Kamalesh2026/DIY-Hydrogel-Touch-Sensor/README.md

# DIY-Hydrogel-Touch-Sensor
Hydrogel Pyramidal Needle based Touch sensor using touch stress as mechanical input and resistance change as output.
