Kamalesh2026/DIY-Hydrogel-Touch-Sensor/Documentation.pptx

## Mechanical Stimuli Based Touch and Tap Sensor to render resistive Output

Kamalesh Roy
kroy.nano21@gmail.com
roykamalesh.acdm@gmail.com

## Slide 2

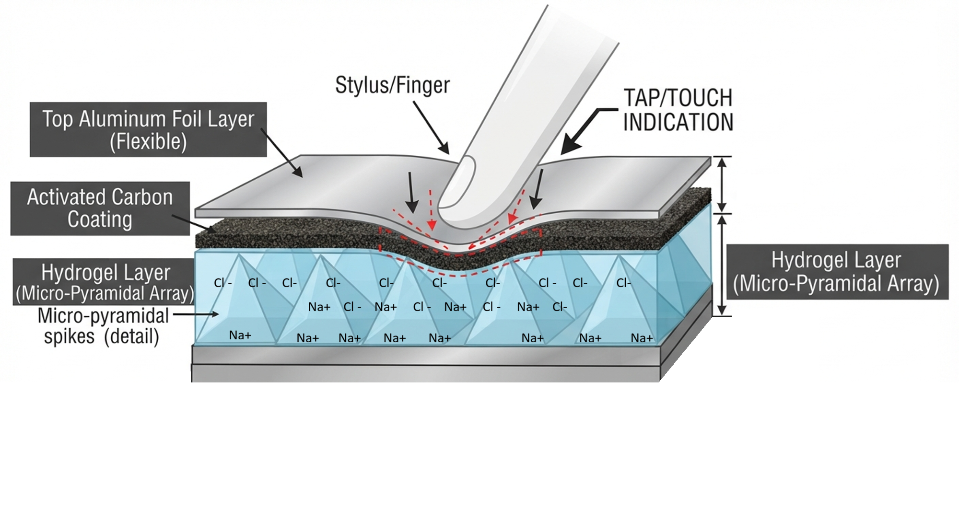
[picture p1: figure]

Pyramidal PVA Hydrogel Structures Soaked in NaCl Electrolyte

Converts touch into Resistance change

## Slide 3

3D Printed PLA Template

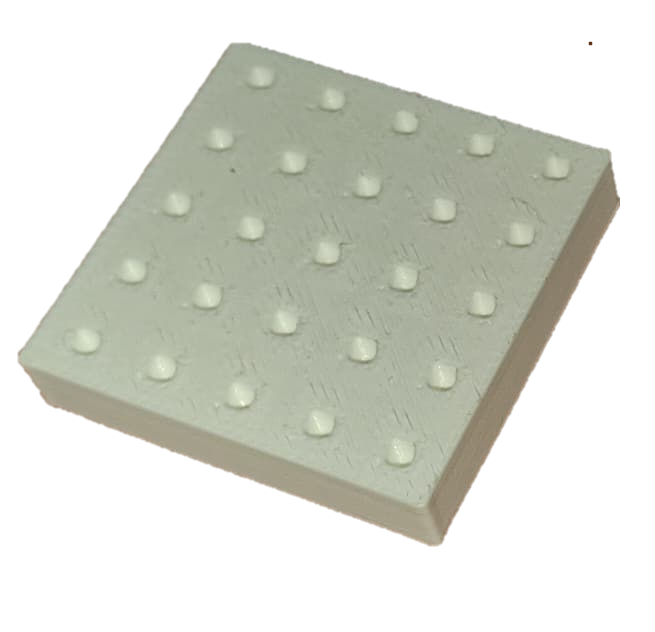
[picture p2: figure]
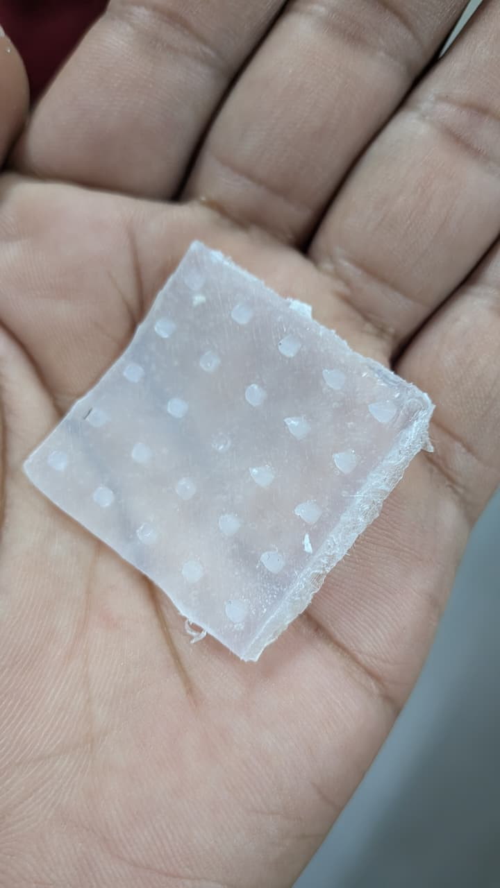
[picture p3: figure]
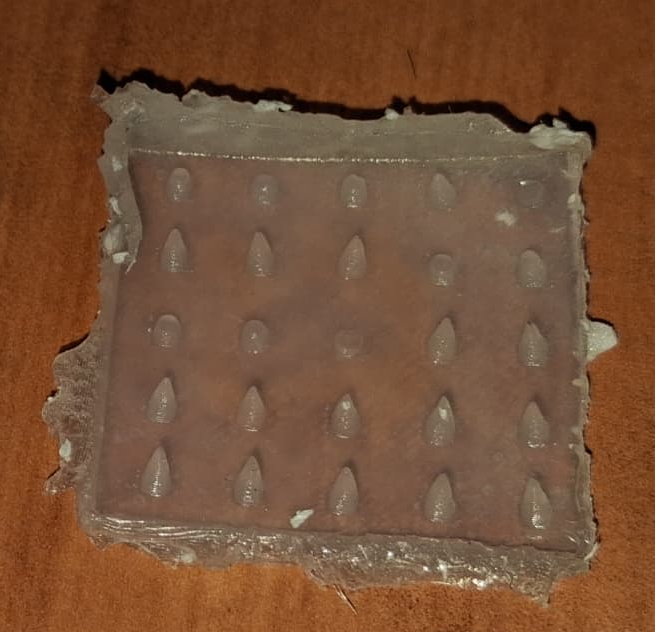
[picture p4: figure]

PVA Hydrogel
Casting, 13% PVA

3 Cycles of Freezing & Thawing,
(20 hr at -20 degree C) and 4 hr at Room temperature.

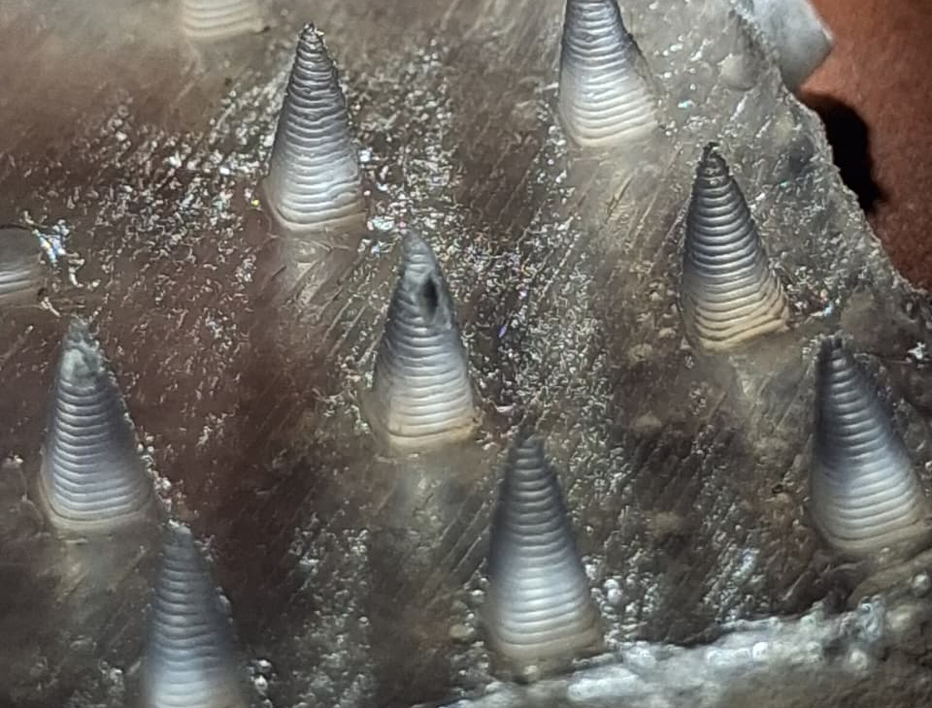
[picture p5: figure]
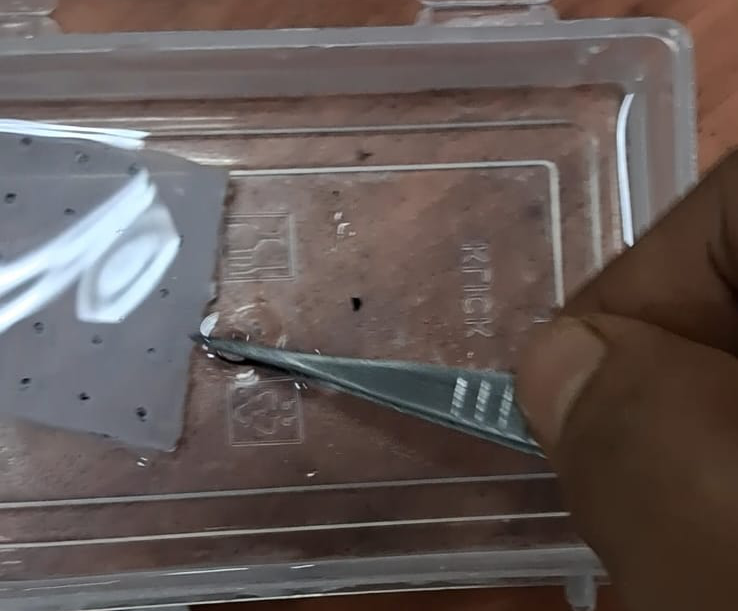
[picture p6: figure]

Making The gel conductive with Electrolyte immersion

## Slide 4

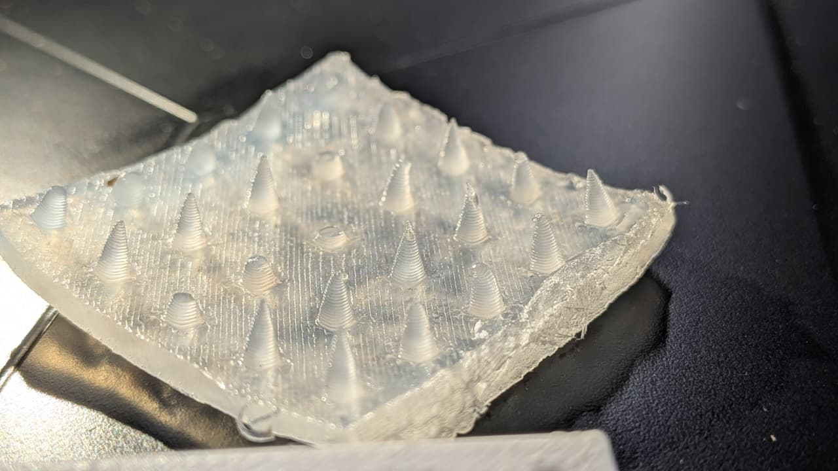
[picture p7: figure]

Hydrogel Layer with Pyramidal Needles after 3 cycles of Freezing & Thawing

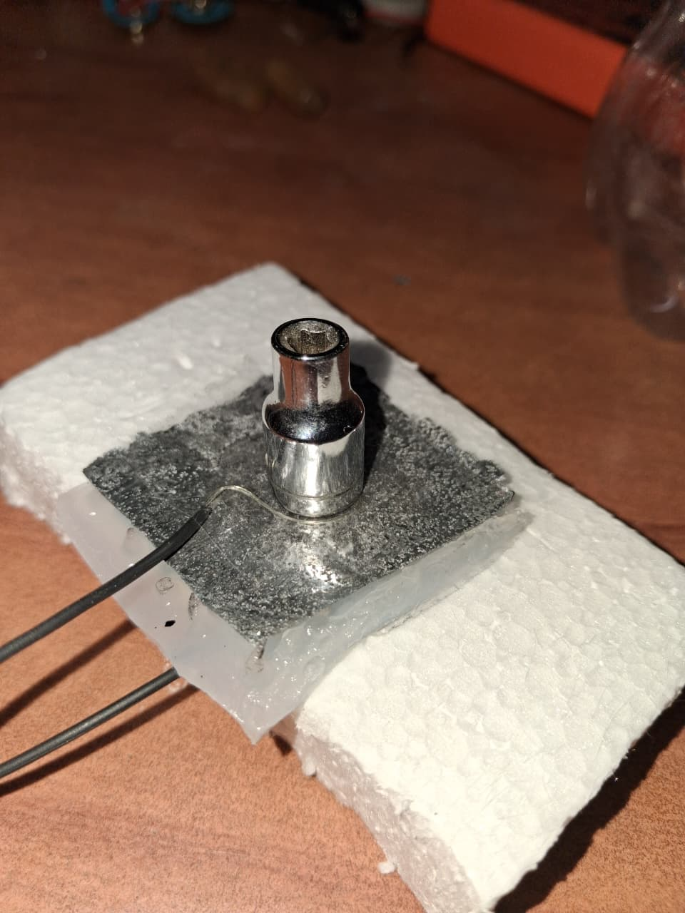
[picture p8: figure]

Hydrogel Layer between two electrode with weight.

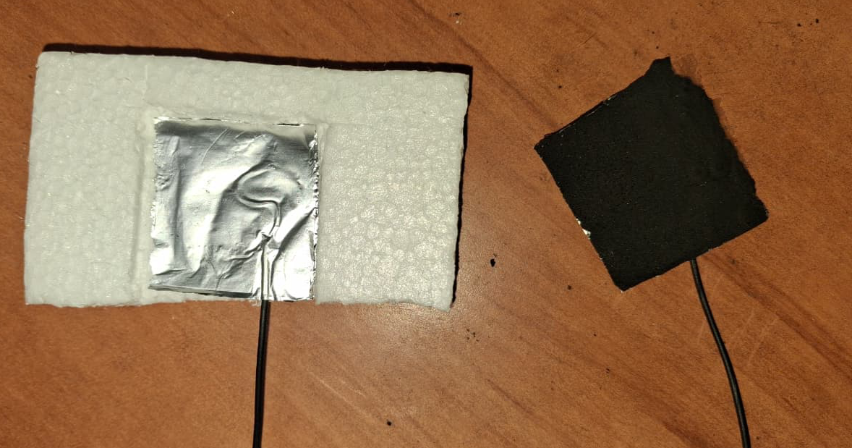
[picture p9: figure]

Bottom Electrode, Al Sheet

Top Electrode, Al Sheet Coated with Activated Carbon Paint

## Slide 5

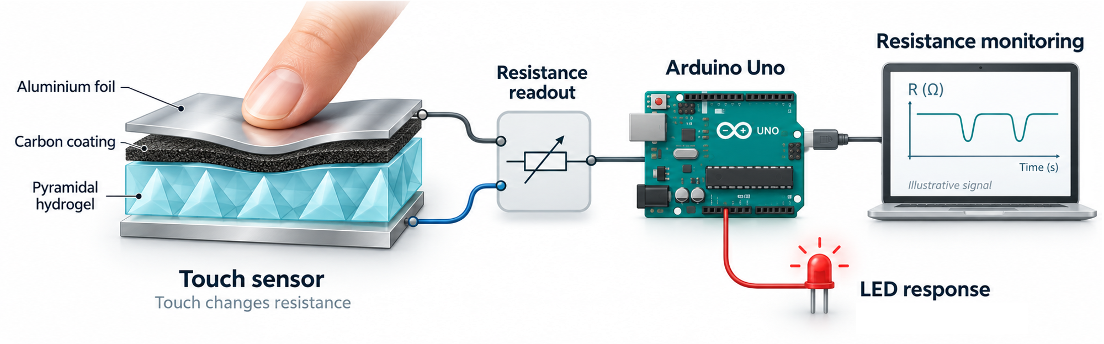
[picture p10: figure]
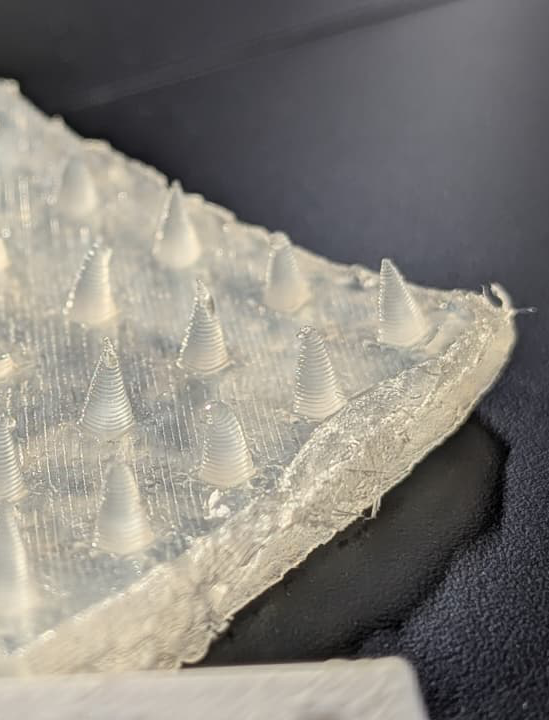
[picture p11: figure]
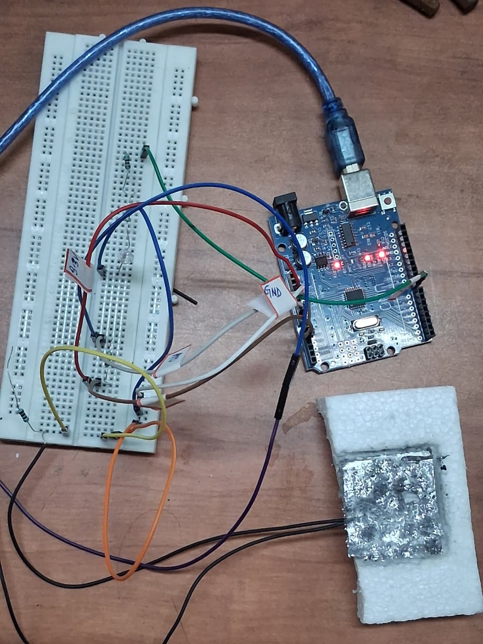
[picture p12: figure]
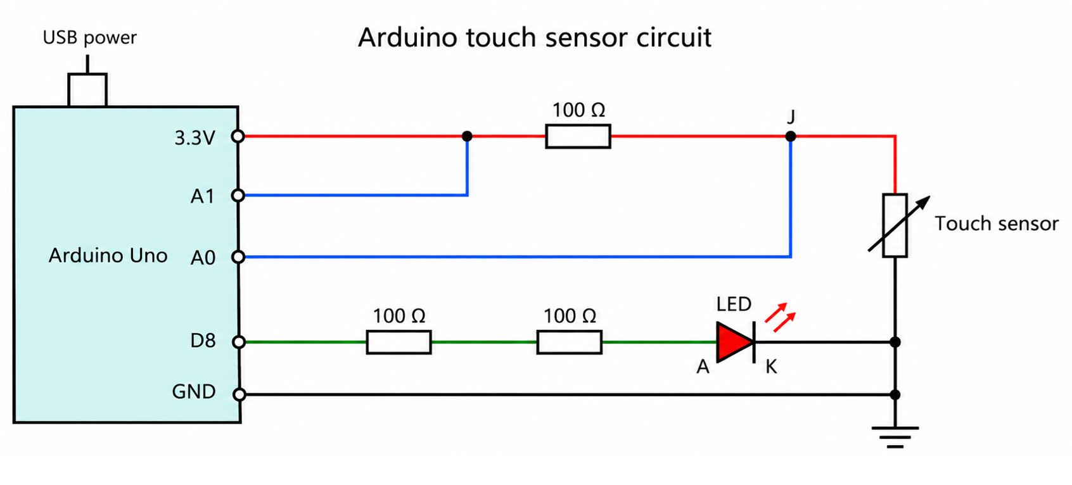
[picture p13: figure]

Fig. Circuit Design, Uno Integration

Arduino Uno

Touch Area

## Slide 6

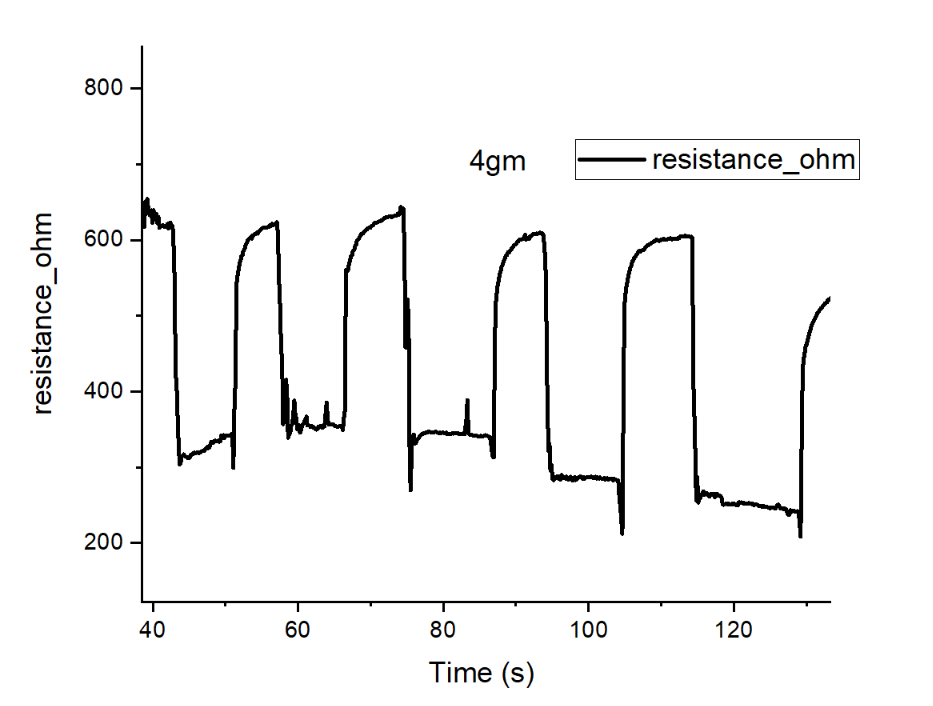
[picture p14: figure]
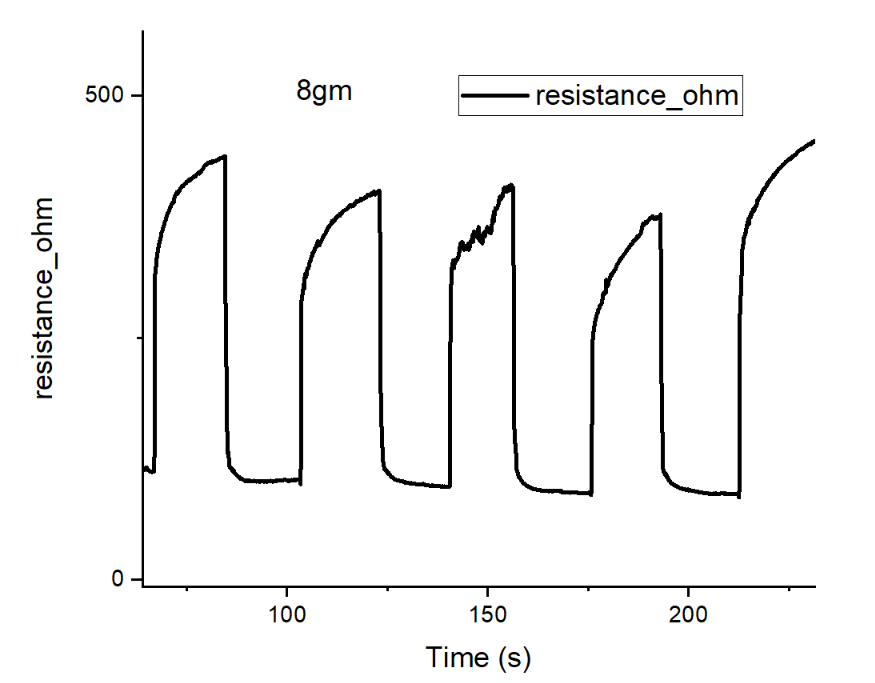
[picture p15: figure]
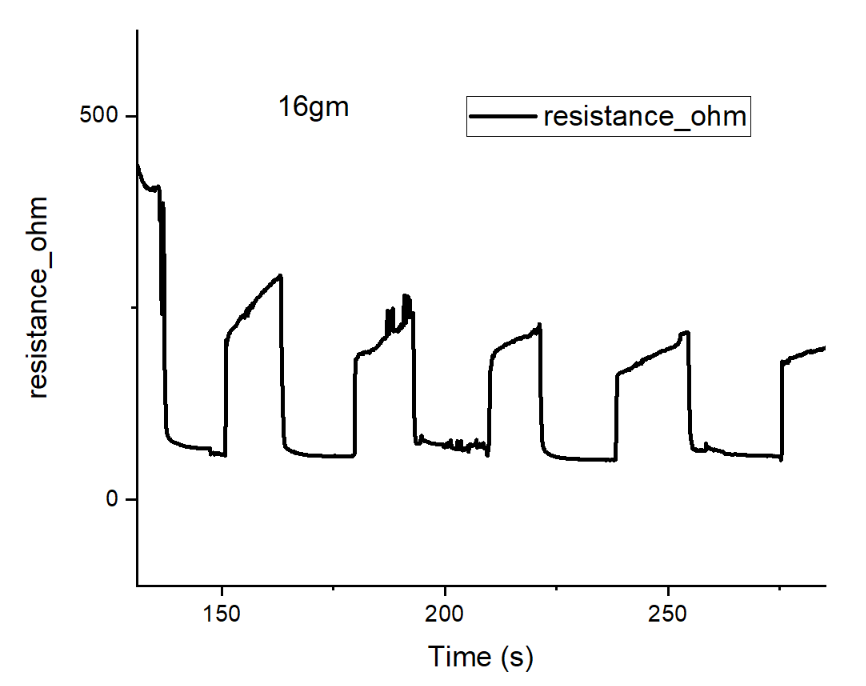
[picture p16: figure]
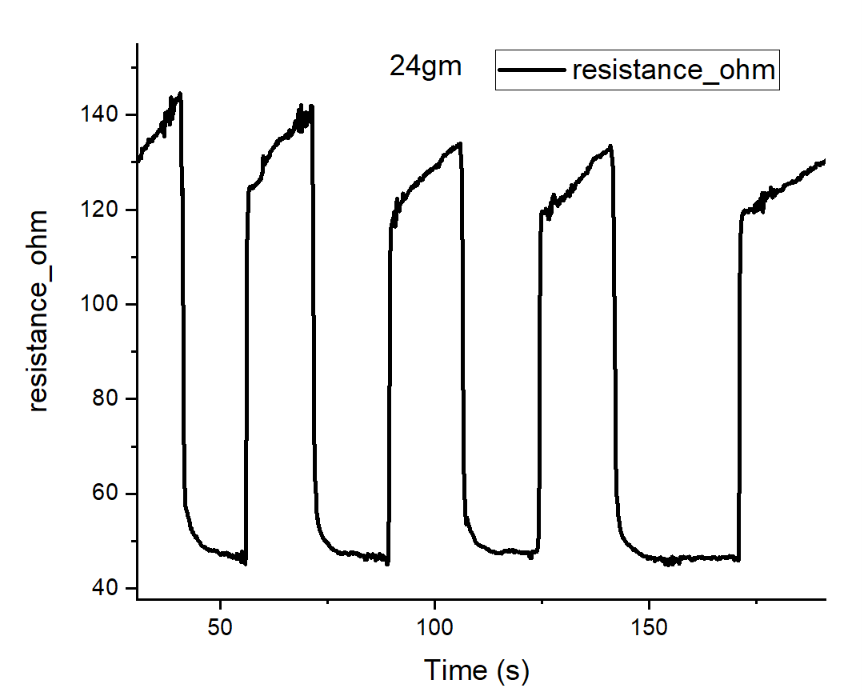
[picture p17: figure]
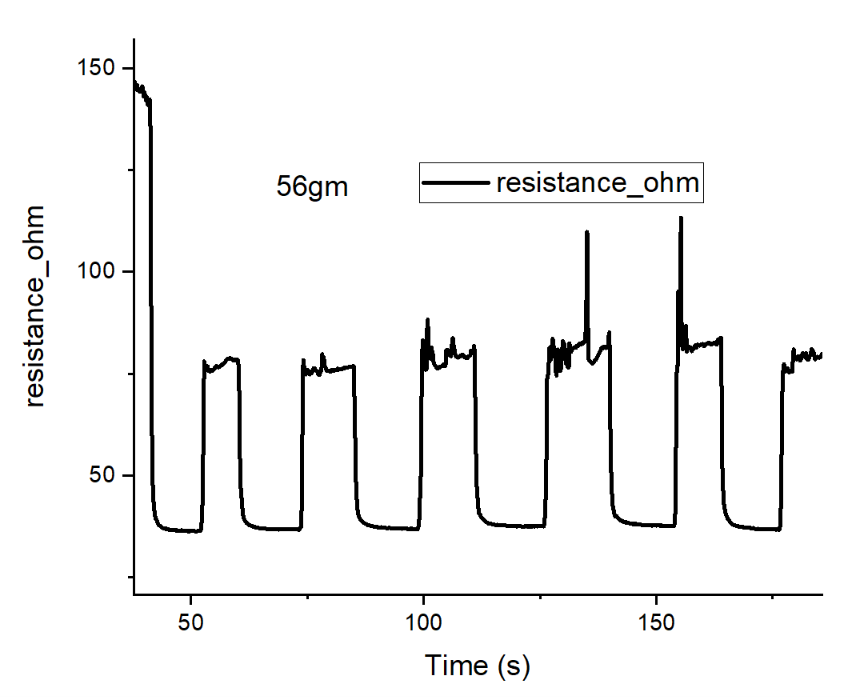
[picture p18: figure]
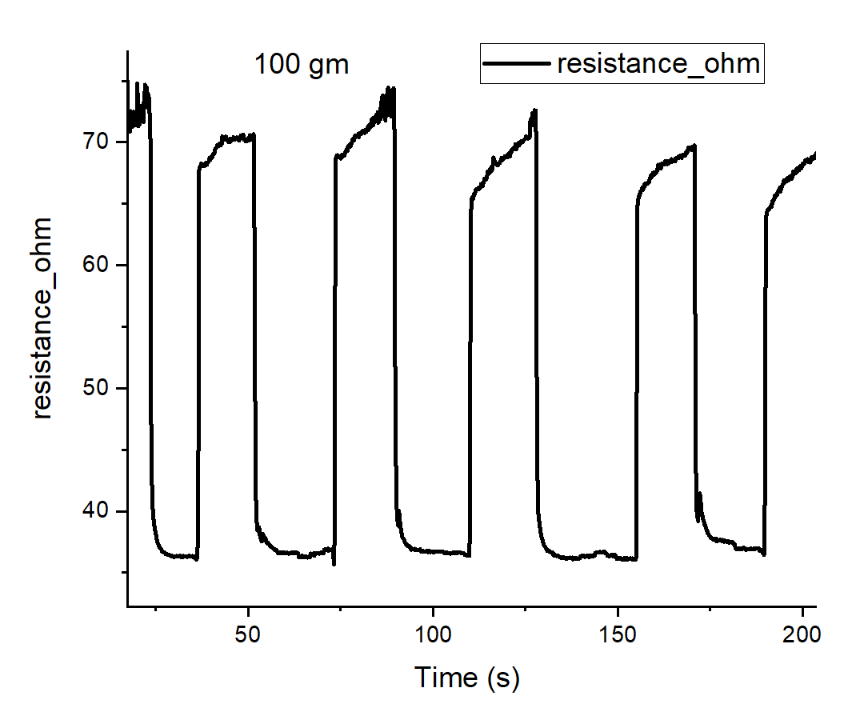
[picture p19: figure]
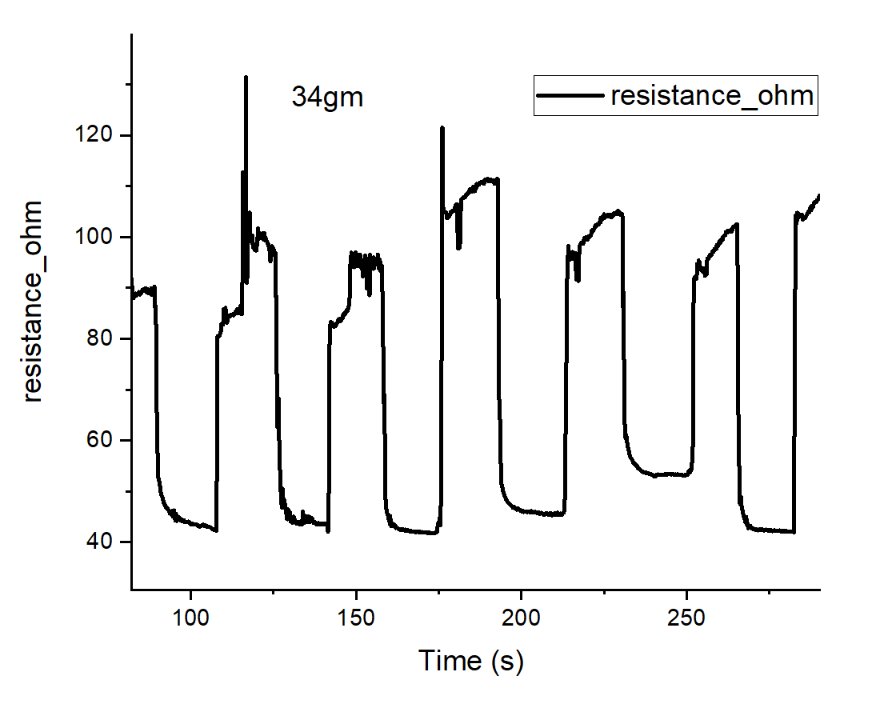
[picture p20: figure]

Fig. : Changes in resistance under various weight from 4gm to 100 gm. As the Pyramidal structures have some thawing problem hence the baseline is mostly varying. (Needs to be optimized after several rounds of freezing and thawing.)

## Slide 7

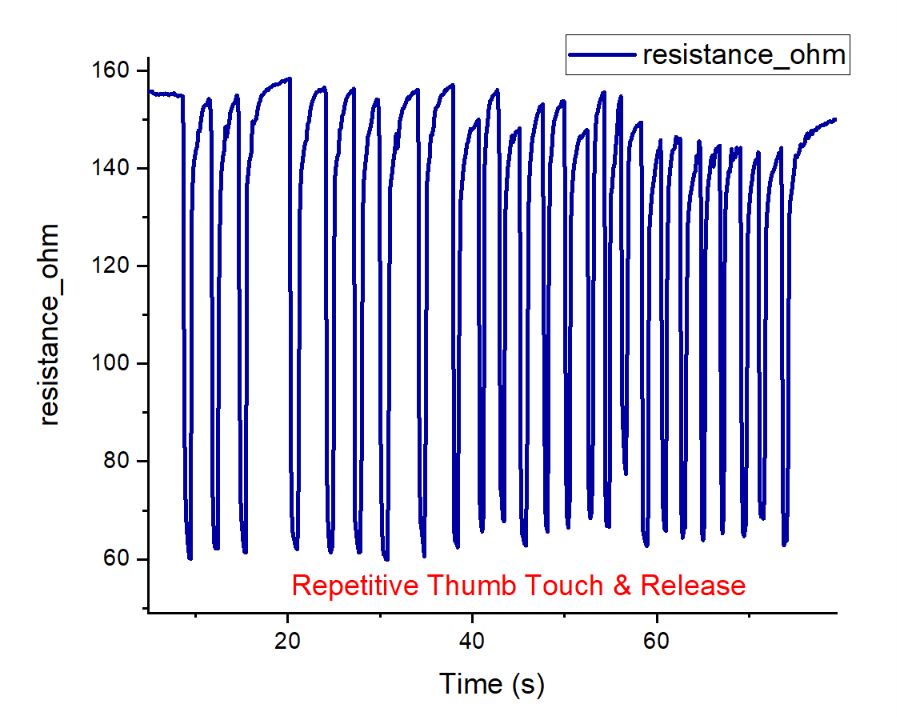
[picture p21: figure]
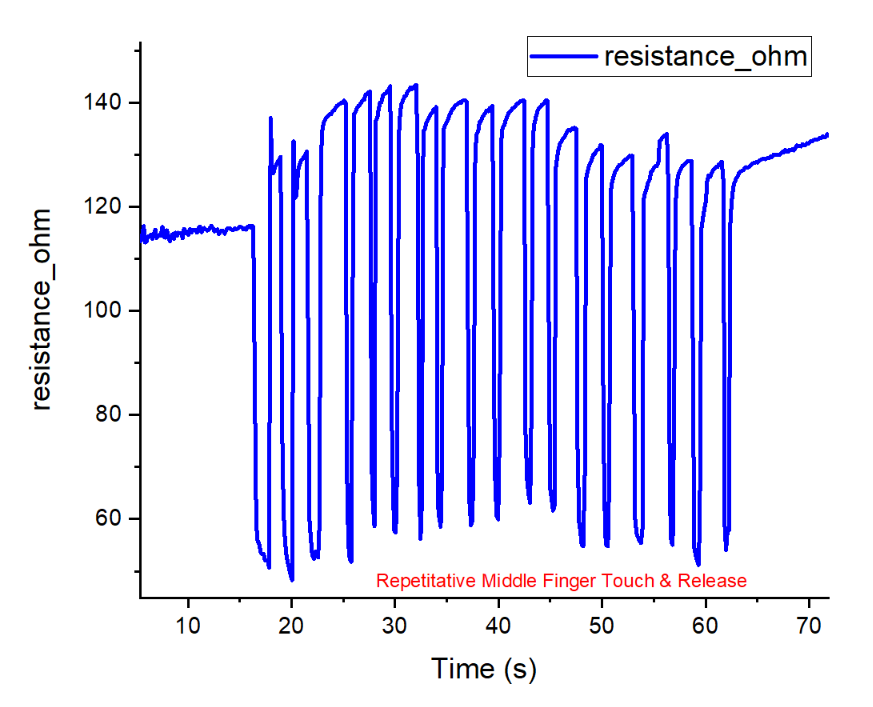
[picture p22: figure]
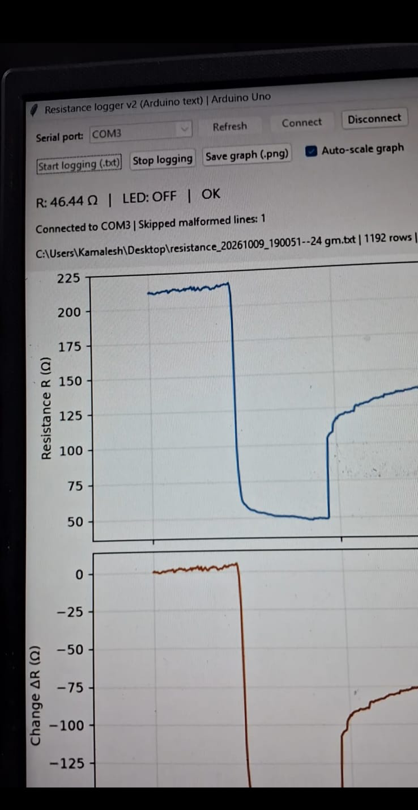
[picture p23: figure]
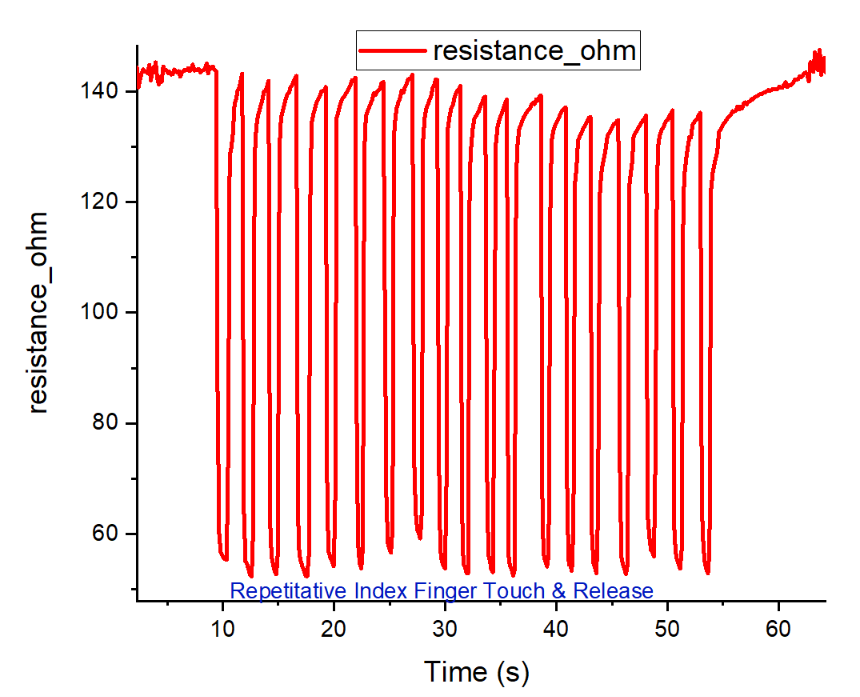
[picture p24: figure]
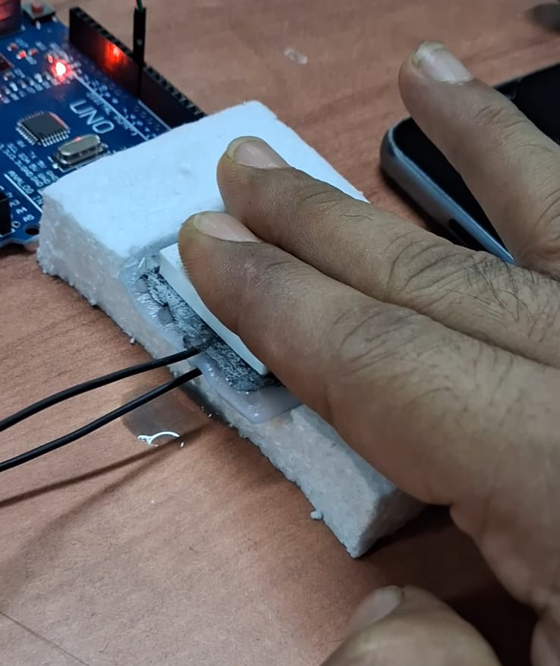
[picture p25: figure]

Fig. : changes in Resistance under various finger touch and release.

## Slide 8

Potential Utility : Touch Controlled Precision Dosing of Drug

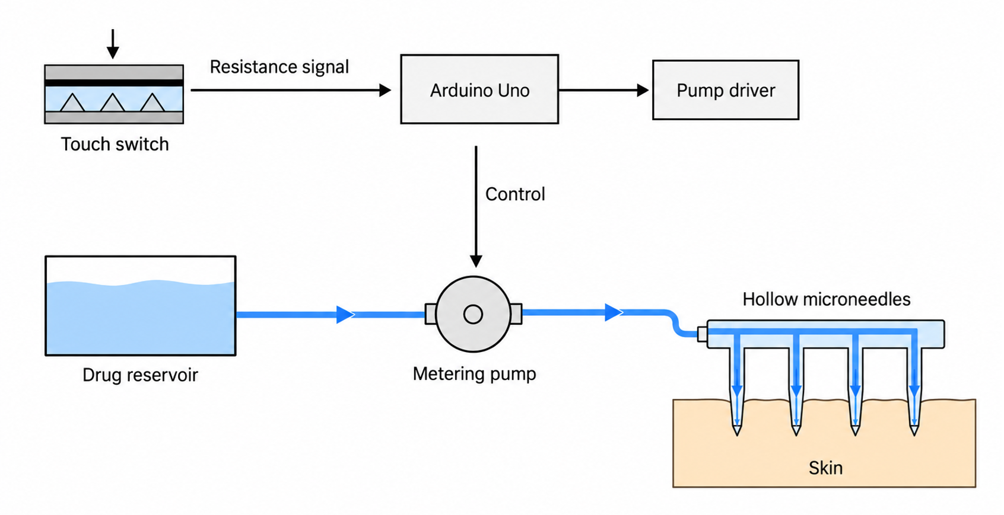
[picture p26: figure]

## Slide 9

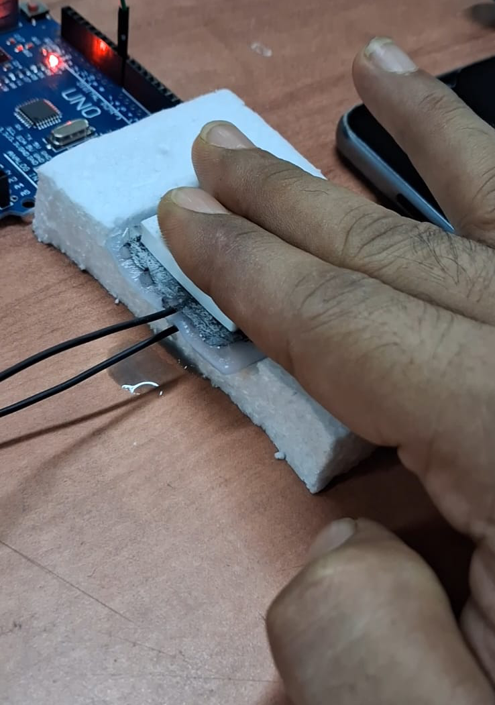
[picture p27: figure]
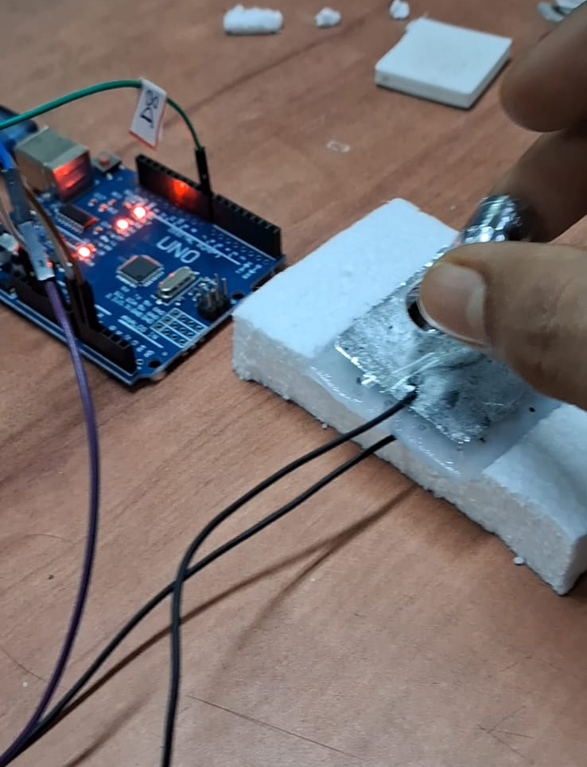
[picture p28: figure]

Various Images.
