Kamalesh2026/DIY-Hydrogel-Touch-Sensor/DIY_Touch_Sensor_Documentation.pdf

# Mechanical Stimuli Based Touch and Tap Sensor to render resistive Output

## Kamalesh Roy kroy.nano21@gmail.com roykamalesh.acdm@gmail.com

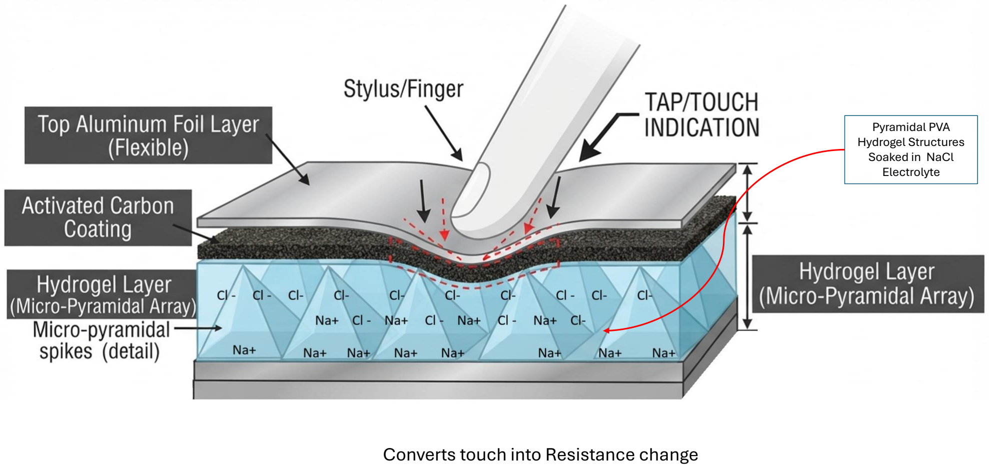
[picture p29: page 2]

Pyramidal PVA
Hydrogel Structures
Soaked in NaCl
Electrolyte

Converts touch into Resistance change

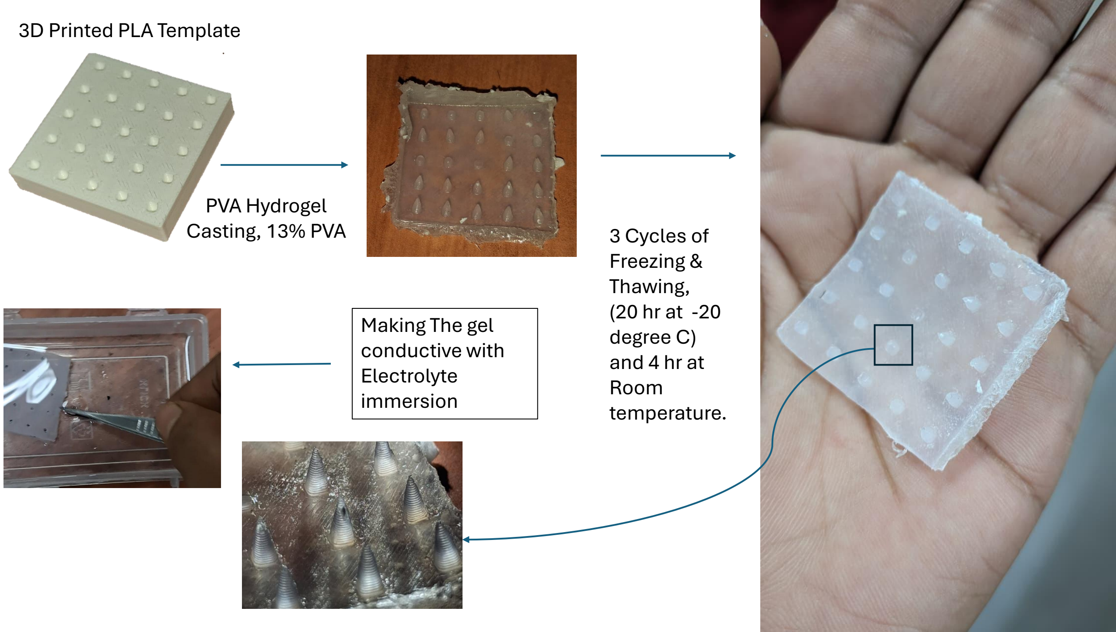
[picture p30: page 3]

3D Printed PLA Template

PVA Hydrogel
Casting, 13% PVA | 3 Cycles of
| Freezing &
| Thawing,
| (20 hr at -20
| degree C)
| and 4 hr at
| Room
| temperature.

Making The gel
conductive with
Electrolyte
immersion

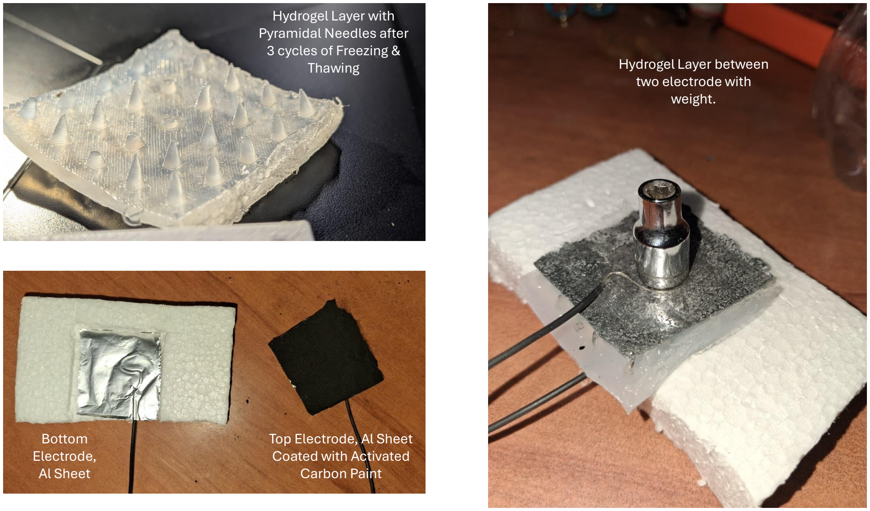
[picture p31: page 4]

Bottom
Electrode,
Al Sheet

Top Electrode, Al Sheet
Coated with Activated
Carbon Paint

Hydrogel Layer with
Pyramidal Needles after
3 cycles of Freezing &
Thawing | Hydrogel Layer between
| two electrode with
| weight.

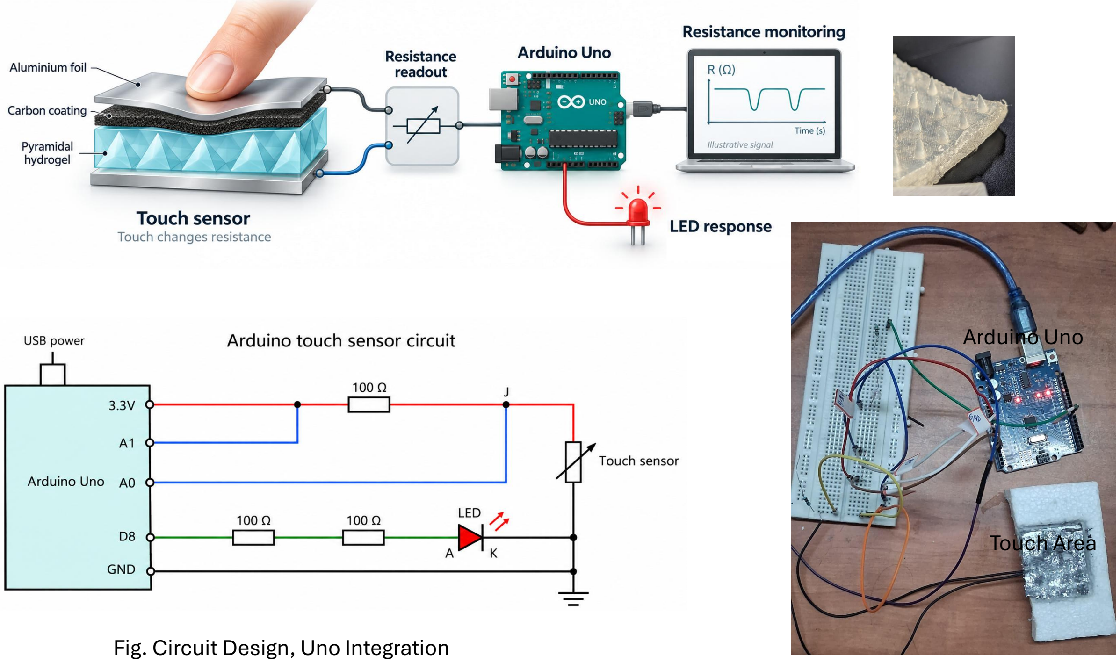
[picture p32: page 5]

Touch Area

Arduino Uno

Fig. Circuit Design, Uno Integration

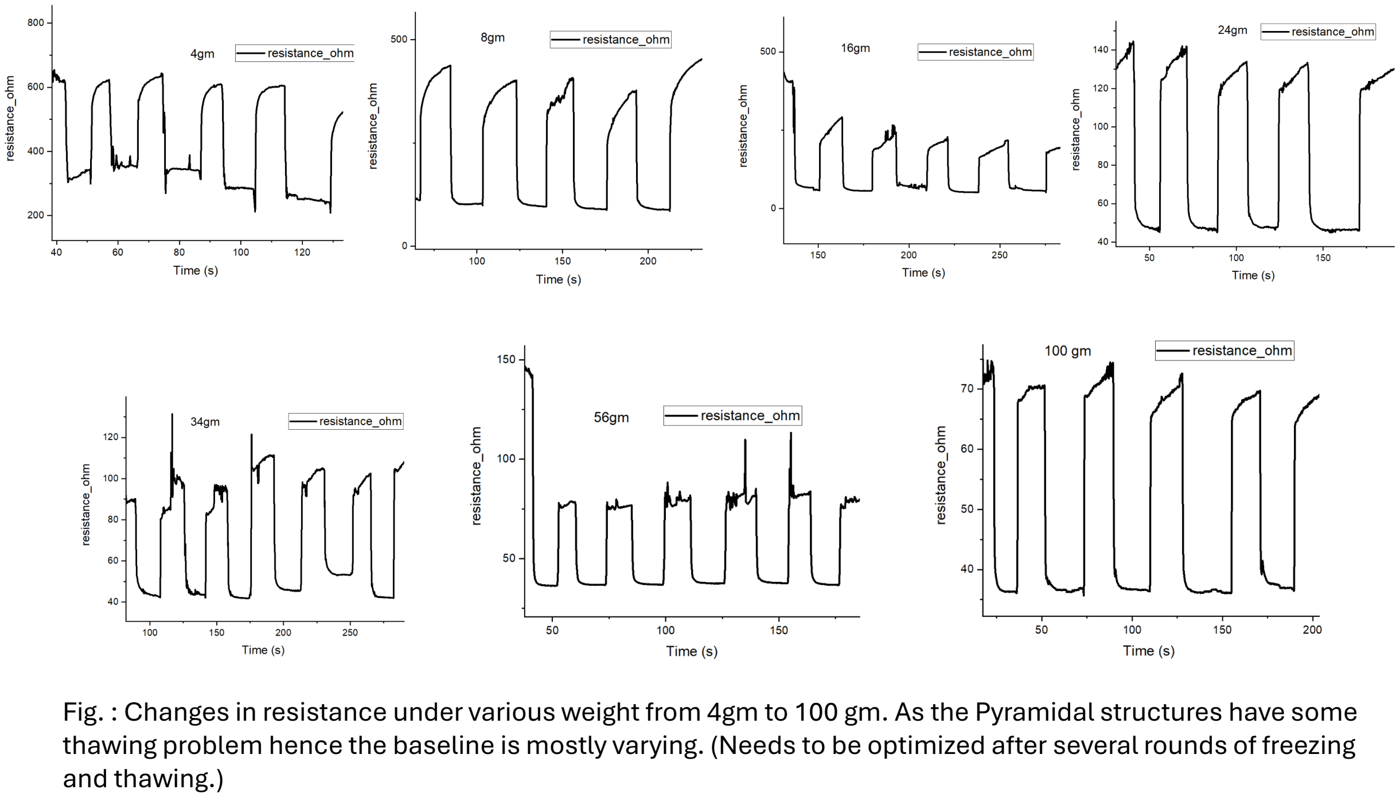
[picture p33: page 6]

Fig. : Changes in resistance under various weight from 4gm to 100 gm. As the Pyramidal structures have some thawing problem hence the baseline is mostly varying. (Needs to be optimized after several rounds of freezing and thawing.)

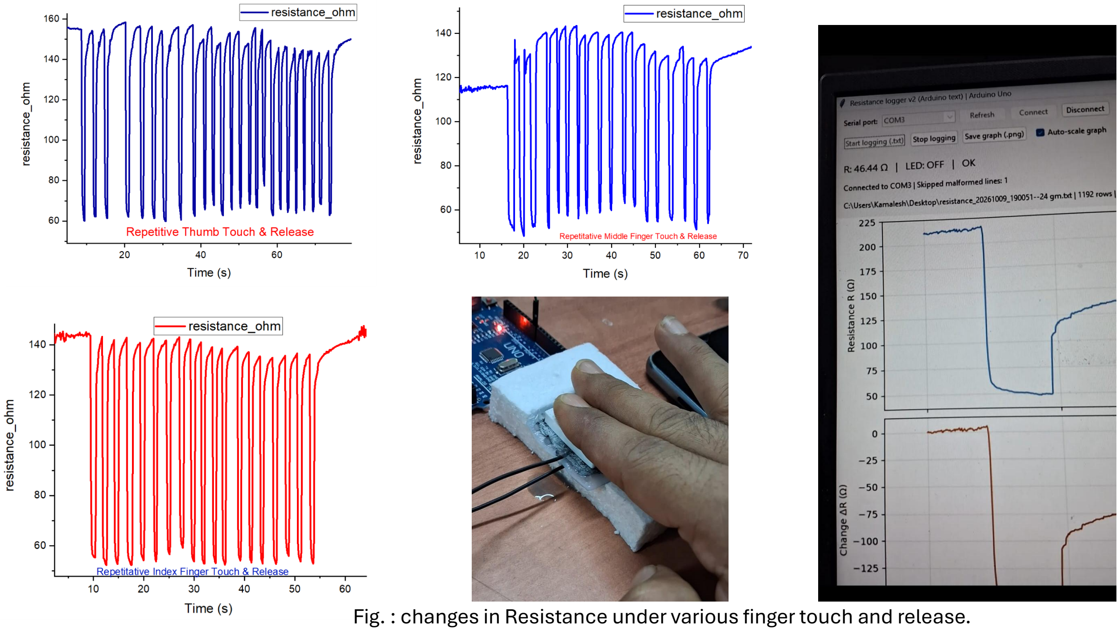
[picture p34: page 7]

Fig. : changes in Resistance under various finger touch and release.

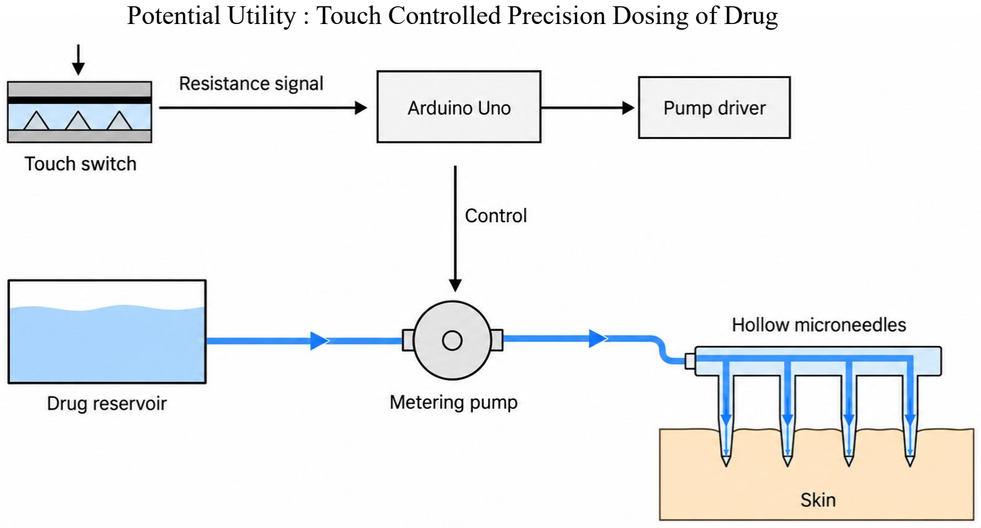
[picture p35: page 8]

Potential Utility : Touch Controlled Precision Dosing of Drug

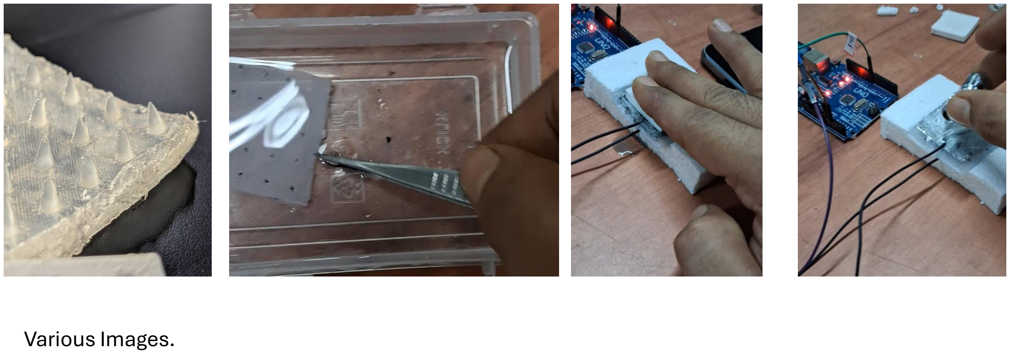
[picture p36: page 9]

Various Images.
